MatPinheiroDev/monitor-qai-mq135/fotos/prototipo_casa_1.jpg

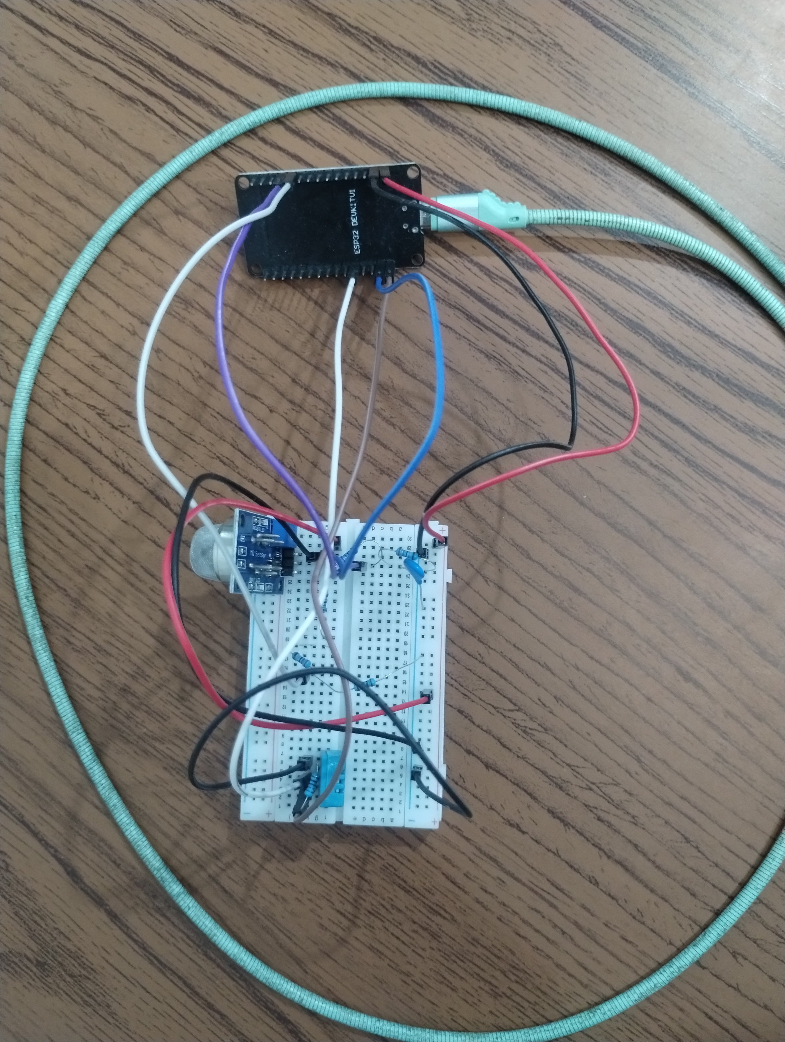
fotos/prototipo_casa_1.jpg
