MatPinheiroDev/monitor-qai-mq135/figuras/fig3_instalacoes.jpg

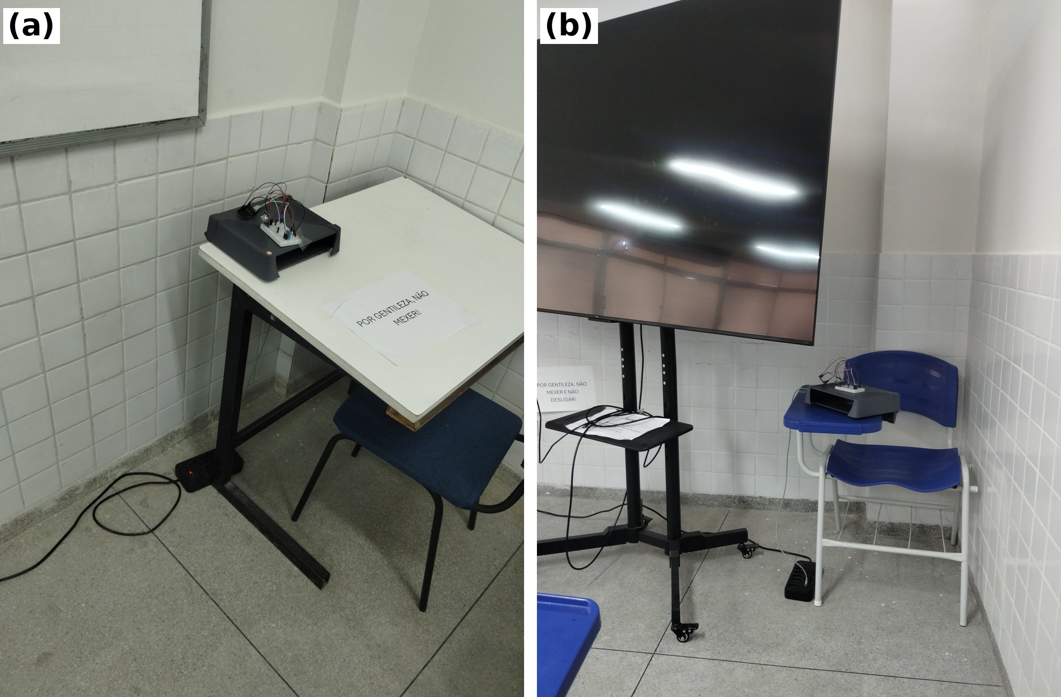
figuras/fig3_instalacoes.jpg
