MatPinheiroDev/monitor-qai-mq135/figuras/fig1a_diagrama.png

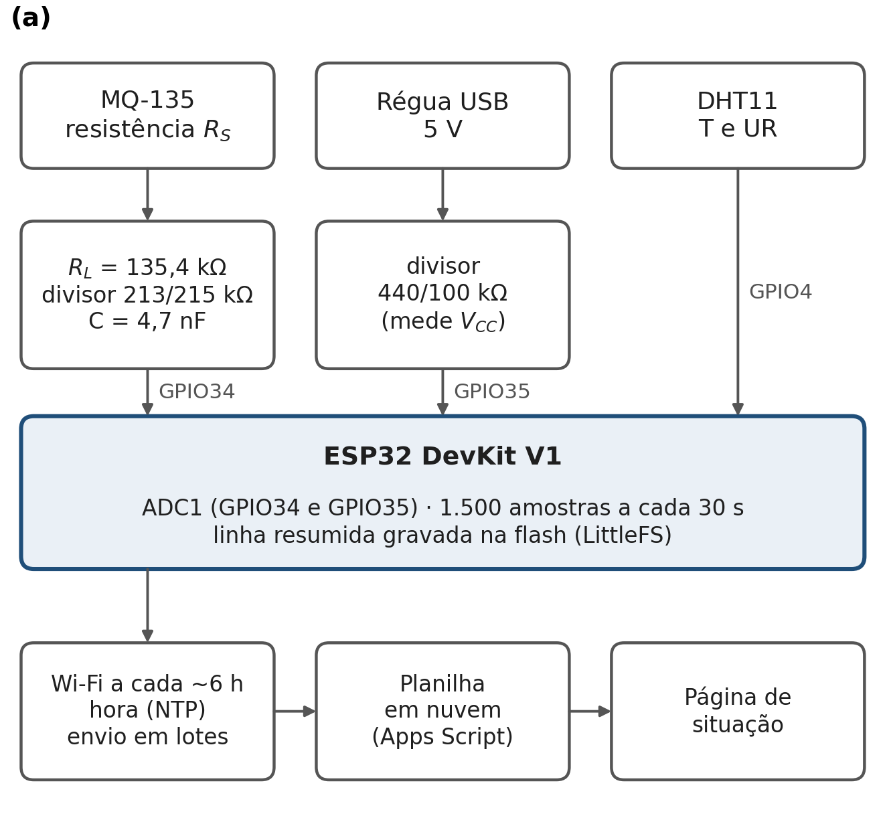
figuras/fig1a_diagrama.png
