MatPinheiroDev/monitor-qai-mq135/figuras/fig1b_prototipo.jpg

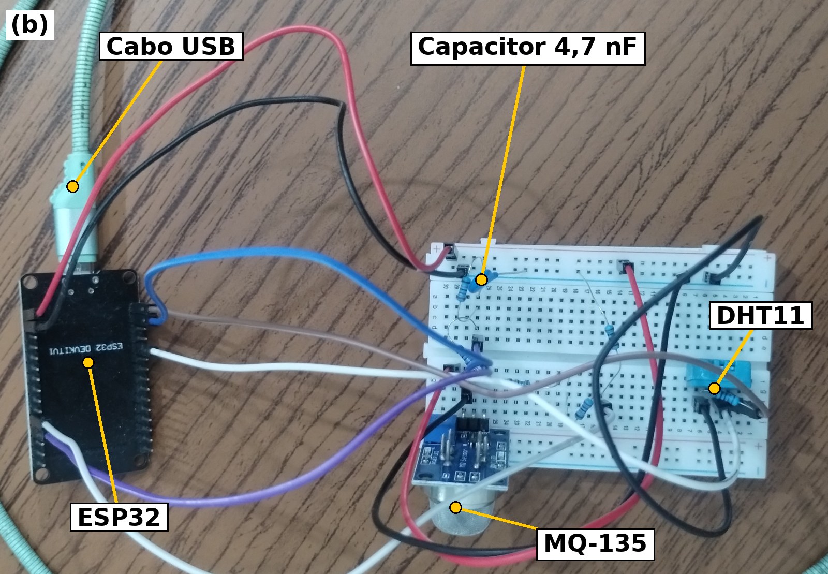
figuras/fig1b_prototipo.jpg
