MatPinheiroDev/monitor-qai-mq135/figuras/fig4_indice.png

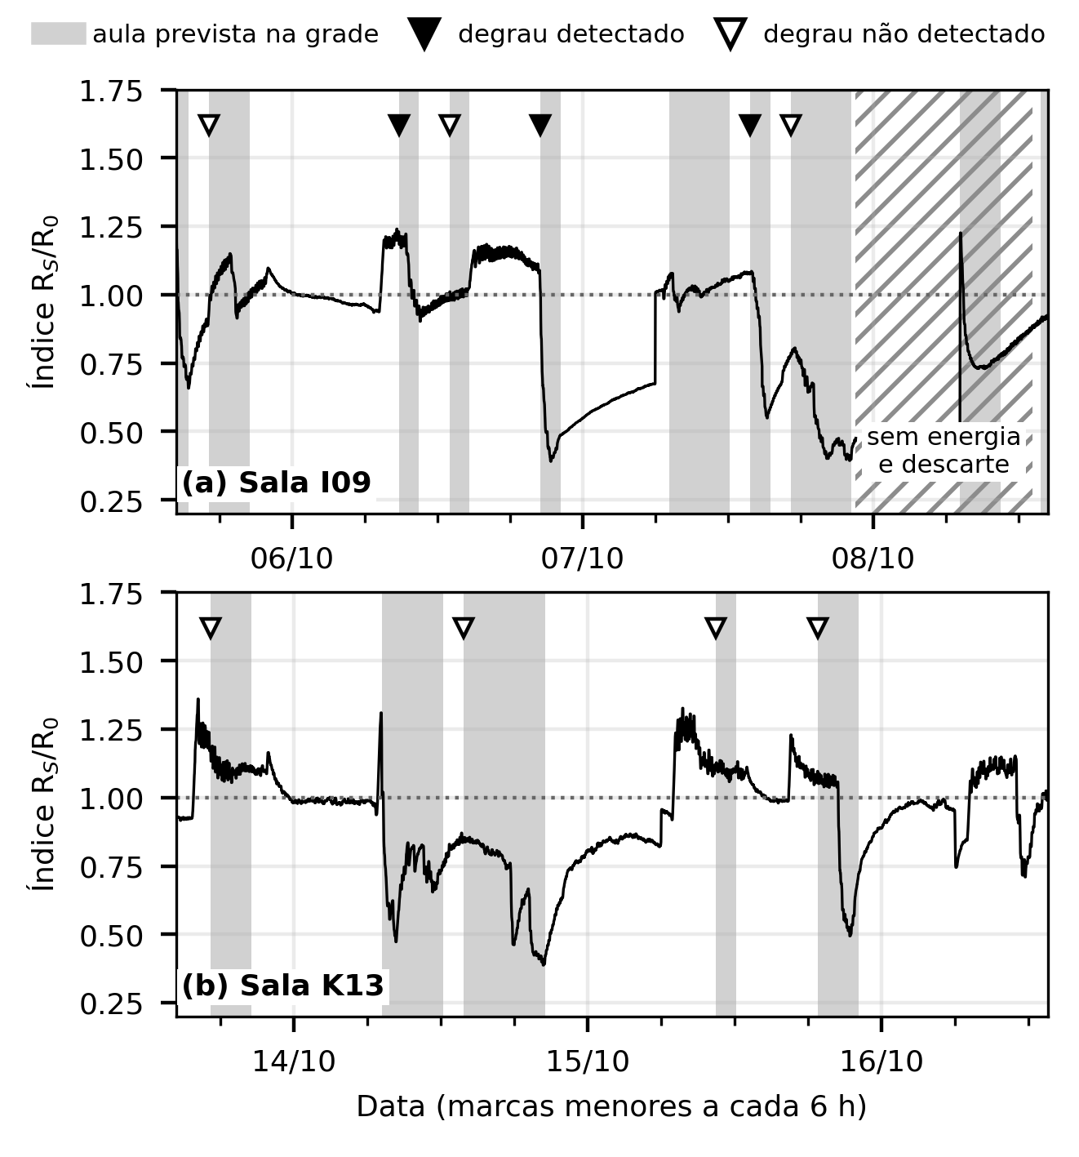
figuras/fig4_indice.png
