MatPinheiroDev/monitor-qai-mq135/fotos/I09_instalacao_0510.jpg

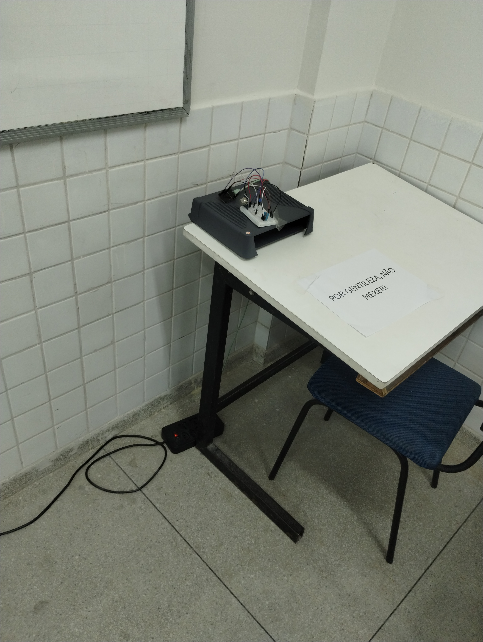
fotos/I09_instalacao_0510.jpg
