MatPinheiroDev/monitor-qai-mq135/fotos/K13_instalacao_1310.jpg

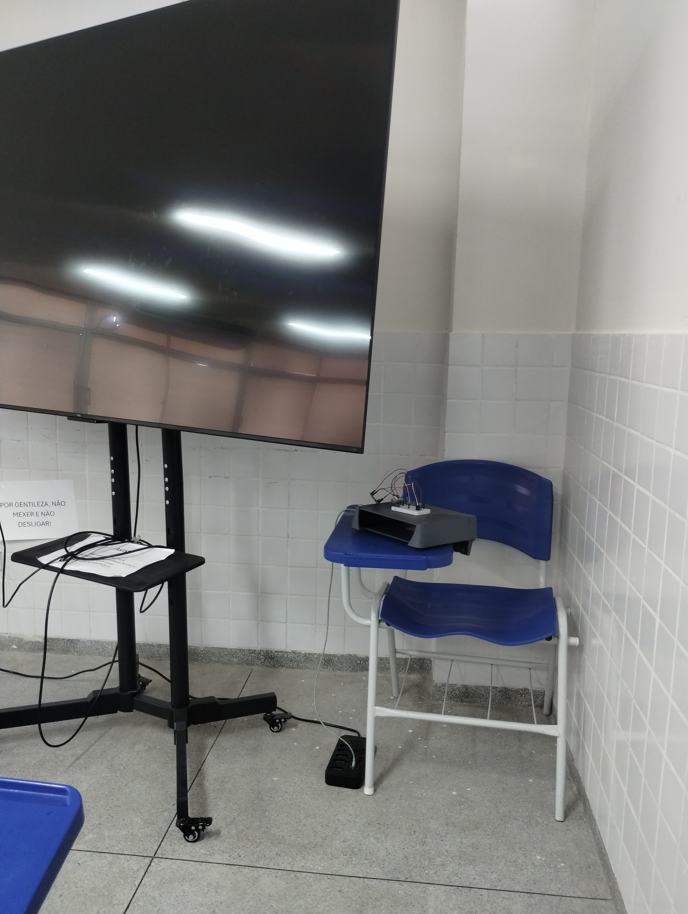
fotos/K13_instalacao_1310.jpg
