MatPinheiroDev/monitor-qai-mq135/figuras/fig2_calibracao.png

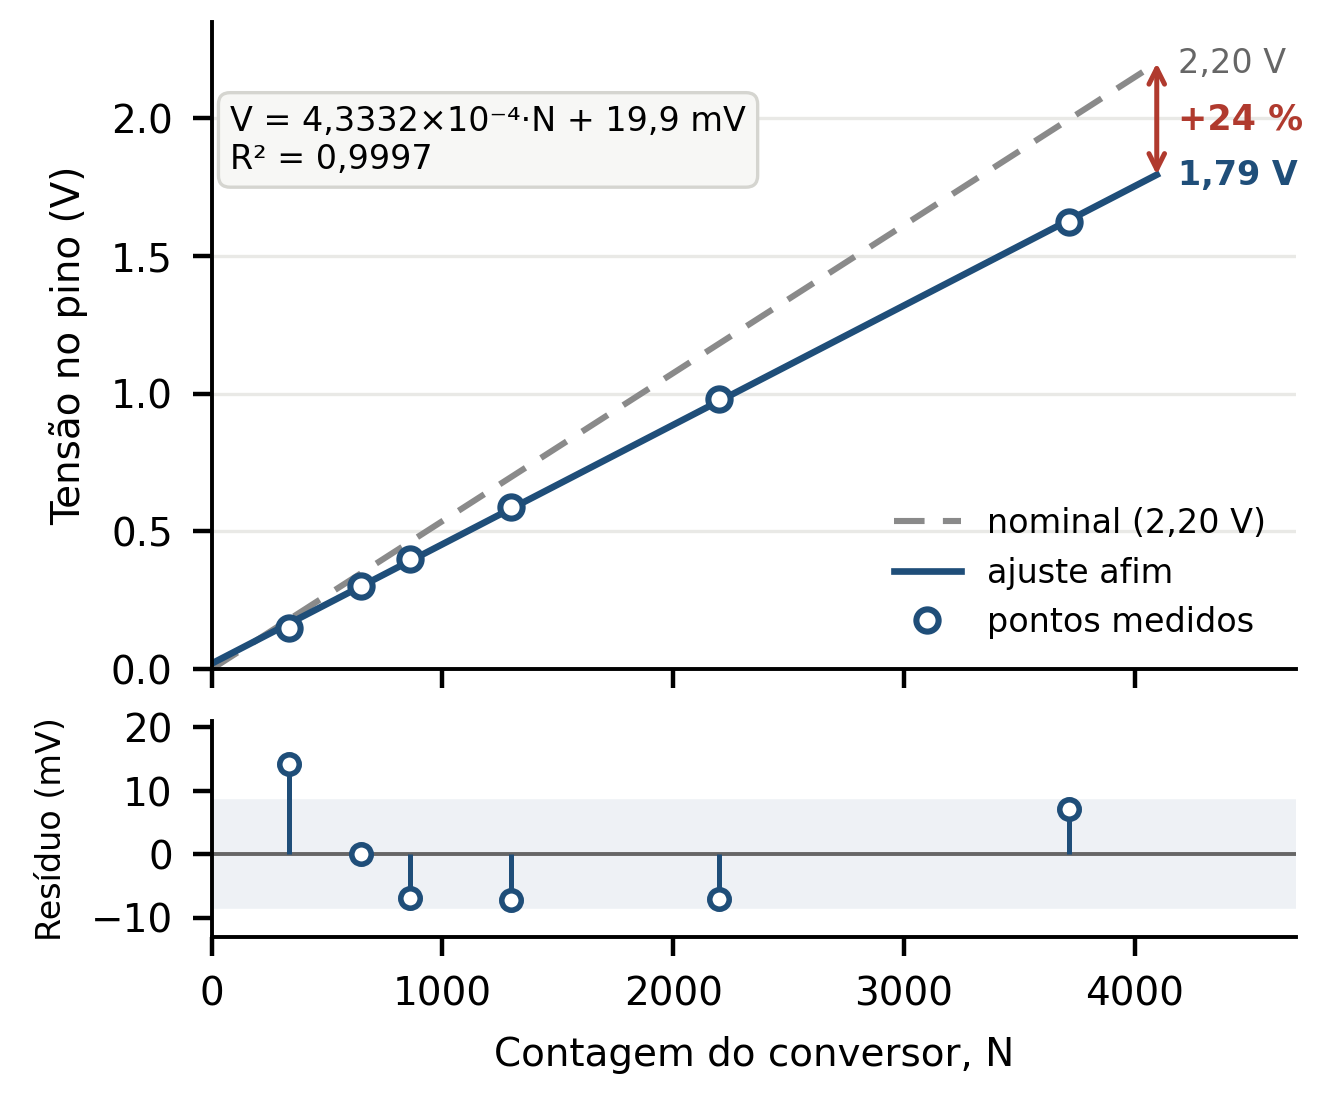
figuras/fig2_calibracao.png
